sydmcbee/Fish-Egg-Counter-2022/Pictures/base_assembled.jpg

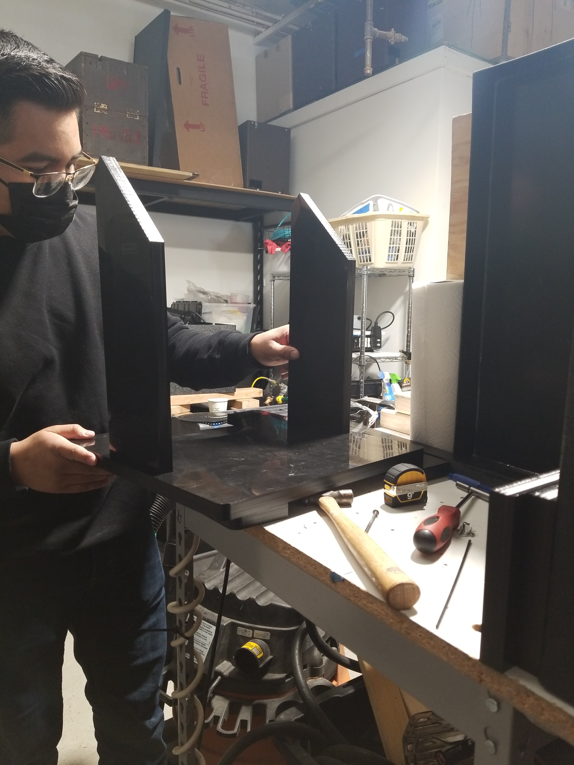
Pictures/base_assembled.jpg
