sydmcbee/Fish-Egg-Counter-2022/Pictures/new_design_Matts.jpg

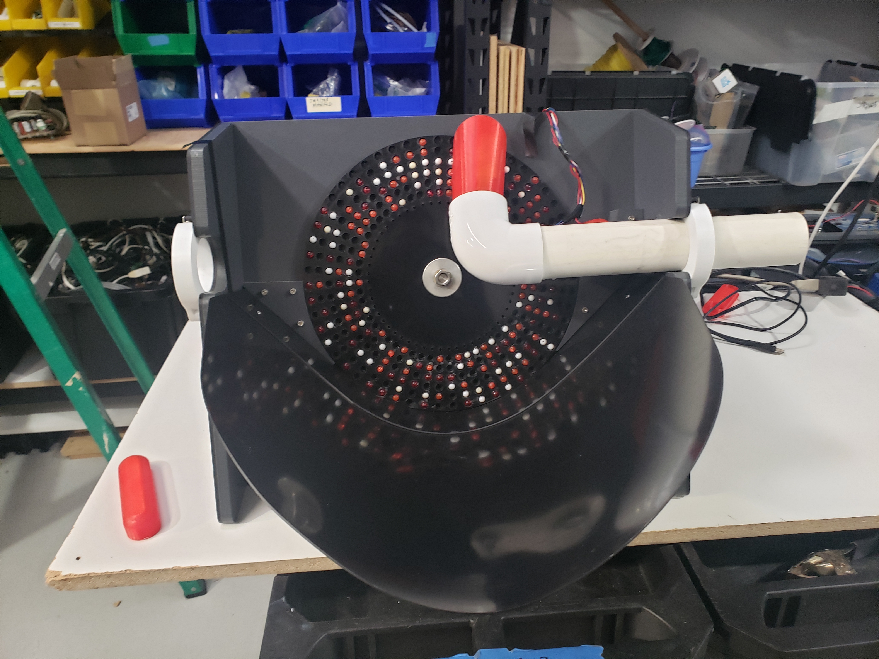
Pictures/new_design_Matts.jpg
