sydmcbee/Fish-Egg-Counter-2022/Weekly Progress Report/1_30_2022 Weekly Progress Report.docx

# Improved Salmon and Trout Egg Counter Weekly Progress Report

Report date: 1/30/2022

- Last Week (time in hours)
  - Team Review
    - Worked on Project Proposal
  - Sydney
    - Project Proposal
  - Sean
    - Project Proposal
  - Agustin
    - Project Proposal
  - Trueman
    - Project Proposal
- Next week
  - Team Plan
    - Write hello world to STM board
    - Take a picture with the ESP32 Cam
    - Complete Final Project Proposal
  - Sydney
    - In-person Meeting on thursday
  - Sean
    - In-person Meeting on thursday
  - Agustin
    - In-person Meeting on Thursday
  - Trueman
    - Power plan
- Blocked
  - Team Blocks
    - Hoping that the Project proposal goes out on time, need both Curt and Johns approval before submission
  - Sydney
  - Sean
    - Possible to Run camera from the larger microprocessor?
  - Agustin
    - Midterm Week
  - Trueman
    - Midterm Week
