sydmcbee/Fish-Egg-Counter-2022/Weekly Progress Report/2_6_2022 Weekly Progress Report.docx

# Improved Salmon and Trout Egg Counter Weekly Progress Report

Report date: 2/6/2022

- Last Week (time in hours)
  - Team Review
    - Project Proposal
    - Capstone progress lecture
  - Sydney
    - Met and worked on code for cam and STM board
  - Sean
    - Met and worked on code for cam and STM board
  - Agustin
    - Met and worked on code for cam and STM board
  - Trueman
    - Tried to find free microSD cards for boards (failed)
- Next week
  - Team Plan
    - Team Review, Pre-review meeting, Meet to work on STM board, Cam, and maybe raspberry pi
  - Sydney
    - Update the Github, source the micro SD card and raspberry pi
  - Sean
    - See how to get openCV into uProc, How to send images through serial GPIO port
  - Agustin
    - Research raspberry pi capabilities, can we get rid of the STM board?
  - Trueman
    - Power Plan
- Blocked
  - Team Blocks
    - Need to email Curt with questions
  - Sydney
    - Can we ditch the STM board?
  - Sean
    - Midterms
  - Agustin
    - One more Midterm
  - Trueman
    - More Midterms
