sydmcbee/Fish-Egg-Counter-2022/Recource Documents/RFFlow - JENSORTER JEIC CAPSTONE SPEC - 2022 - R1.pdf

Target Specifications:
1) Power On Ready to Use
2) Process 300,000 Eggs/Hr - Assume a disk carries 250 Eggs, 20 RPM = 300K Eggs
3) "Batching" Feature
a. User Inputs # Eggs
b. System Batches # Eggs
4) "Counting" Feature
a. Real-Time - # Eggs
b. Post Process - # Eggs/Batch - Good Eggs, Bad Eggs
5) " Image Feature"
a. Dumps images to Screen (Scroll), USB
6) Remote Update of Software (Hook up to PC on Internet)

## JENSORTER "JEIC" CAPSTONE PROJECT - 2022

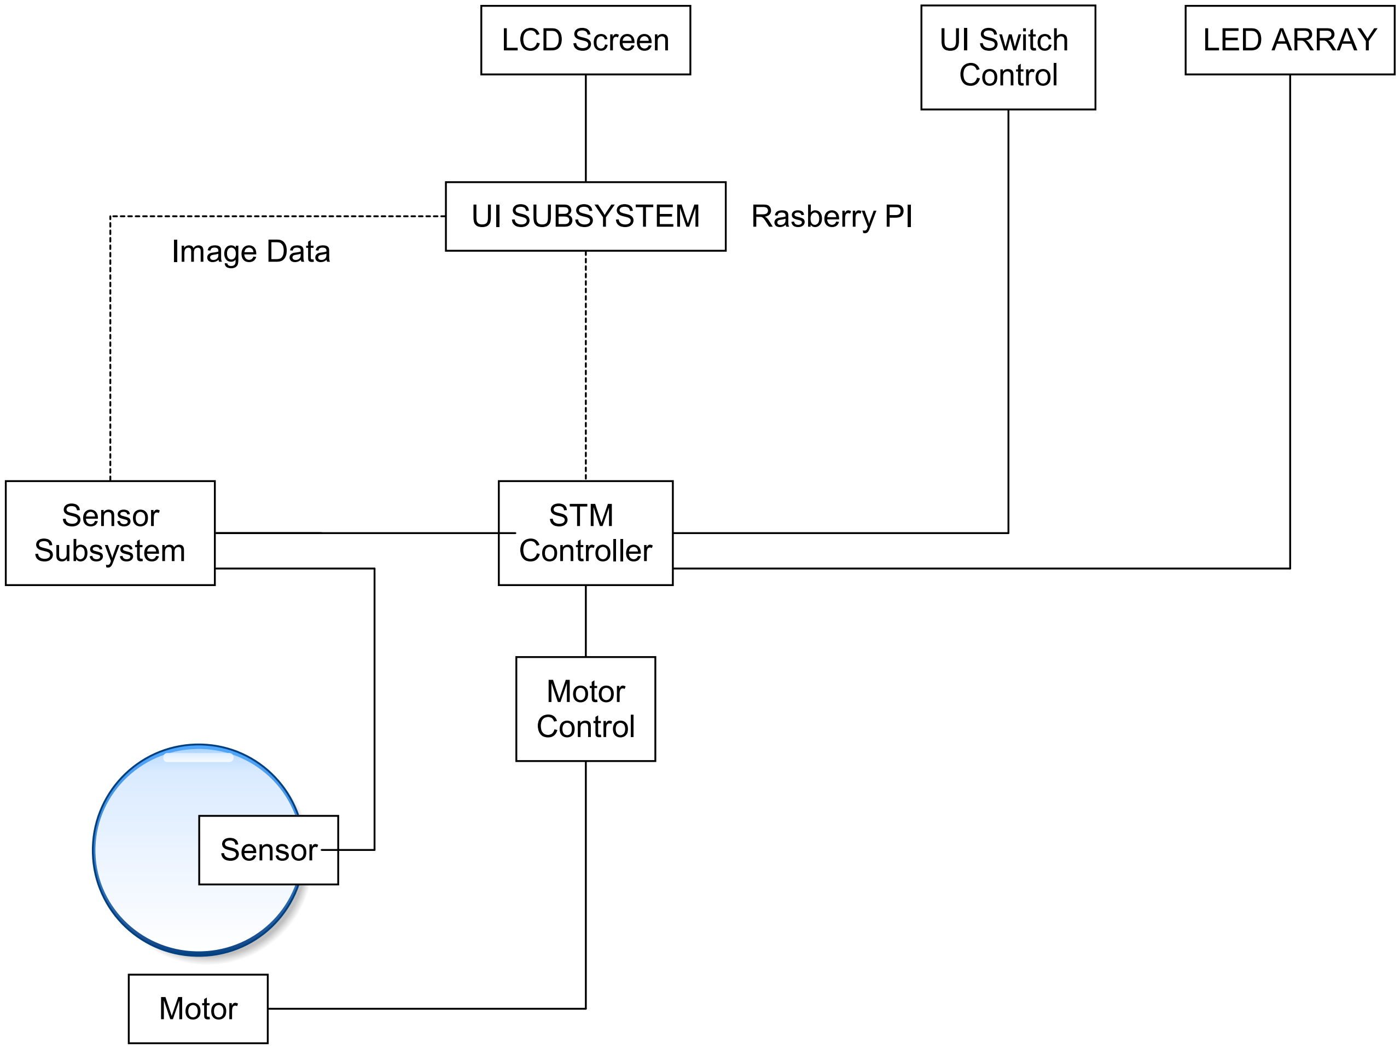
[picture p3: figure]
LCD Screen; UI SUBSYSTEM; Rasberry PI; STM Controller; Sensor Subsystem; Sensor; Motor Control; Motor; UI Switch; LED ARRAY; Control; Image Data
