sydmcbee/Fish-Egg-Counter-2022/Pictures/base_and_plate_assembeled.jpg

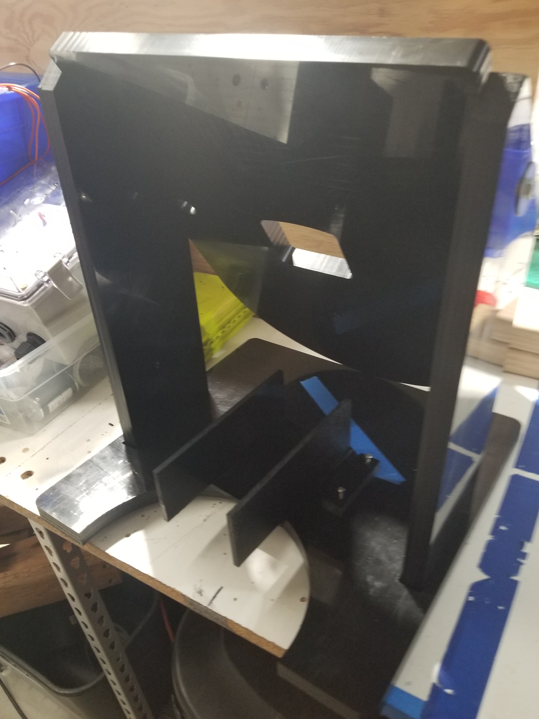
Pictures/base_and_plate_assembeled.jpg
