sydmcbee/Fish-Egg-Counter-2022/Pictures/block diagram.png

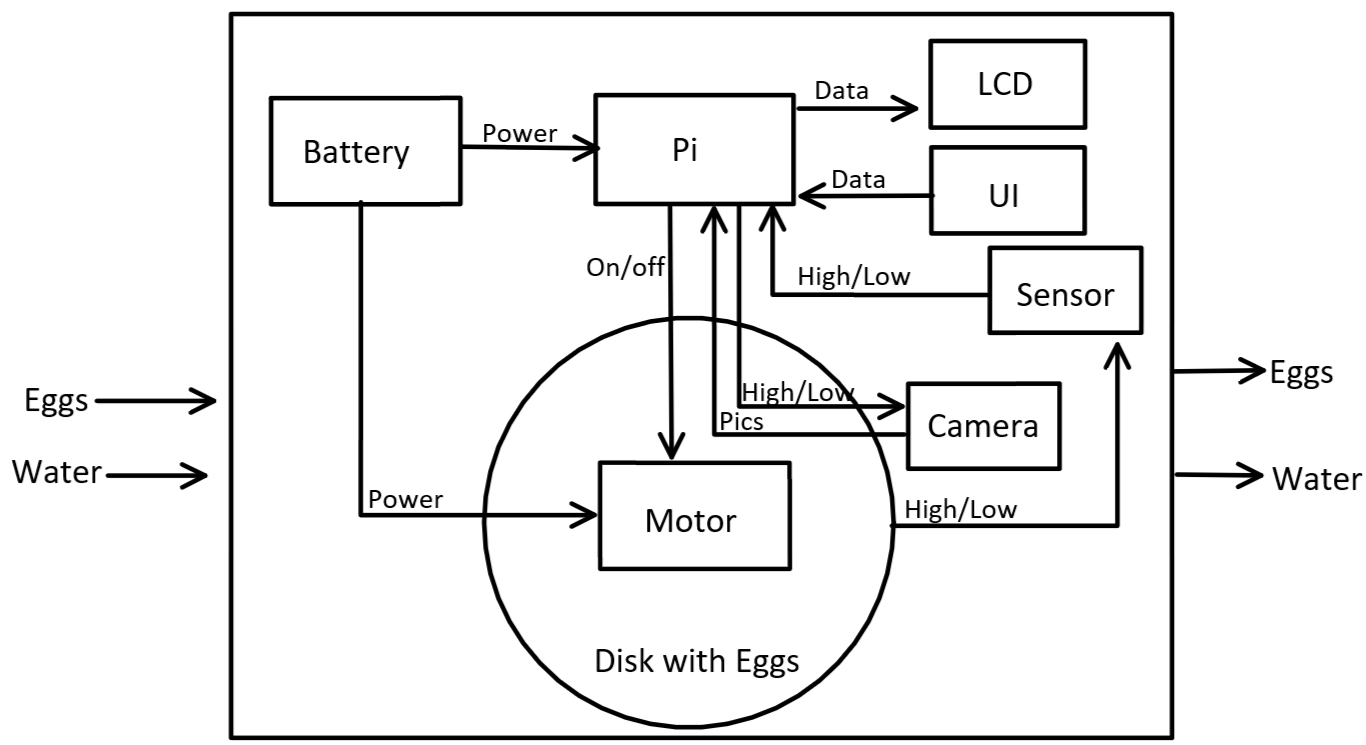
Pictures/block diagram.png
