sydmcbee/Fish-Egg-Counter-2022/Pictures/camera_block.jpg

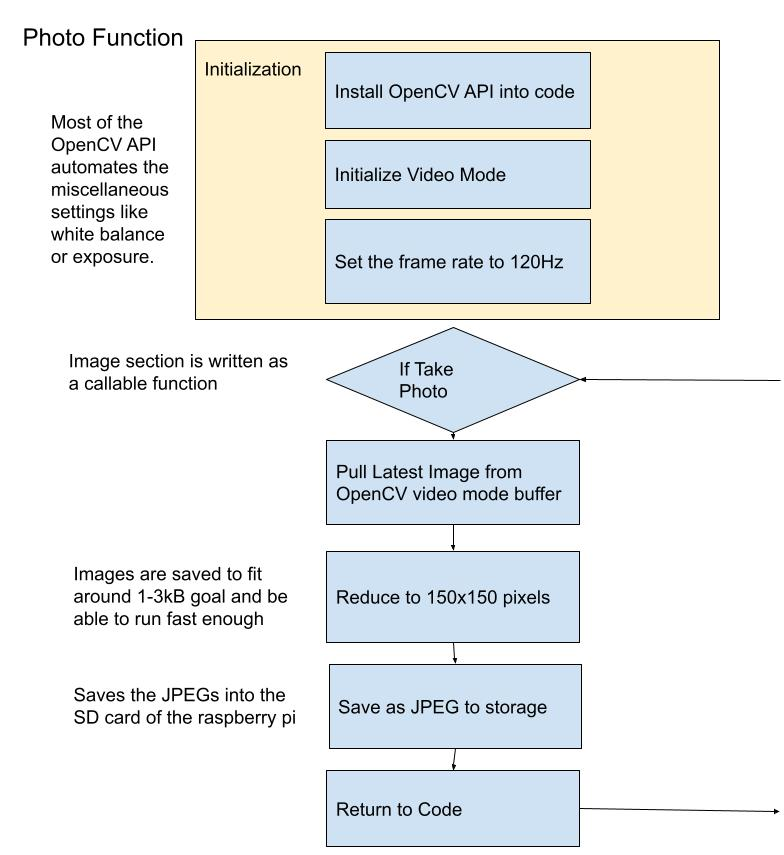
Pictures/camera_block.jpg
