sydmcbee/Fish-Egg-Counter-2022/Pictures/dTQj-8802za0PWdOePcX5d2VXY1fzDKEmULr0gYUjDF9MuVbKbRXO-ENWwPilxfT2EpT9kWhRnJLXRTNyVm9KOn8G_kP1PMThfFYnhR-5R2ii9F7V6LEPkoqE7gjZlxZyjT6fGIWb5VSJZsqkA.png

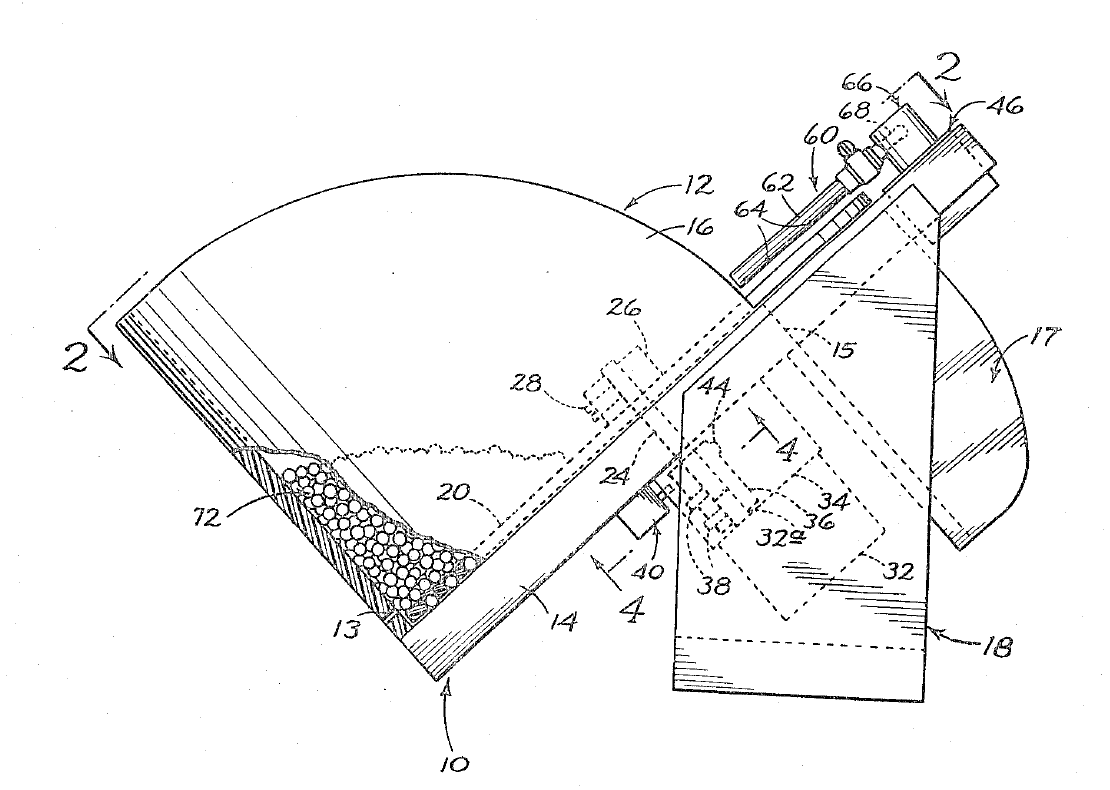
Pictures/dTQj-8802za0PWdOePcX5d2VXY1fzDKEmULr0gYUjDF9MuVbKbRXO-ENWwPilxfT2EpT9kWhRnJLXRTNyVm9KOn8G_kP1PMThfFYnhR-5R2ii9F7V6LEPkoqE7gjZlxZyjT6fGIWb5VSJZsqkA.png
