sydmcbee/Fish-Egg-Counter-2022/Pictures/egg_detection.png

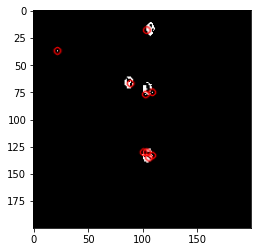
Pictures/egg_detection.png
