sydmcbee/Fish-Egg-Counter-2022/Pictures/gannt2.png

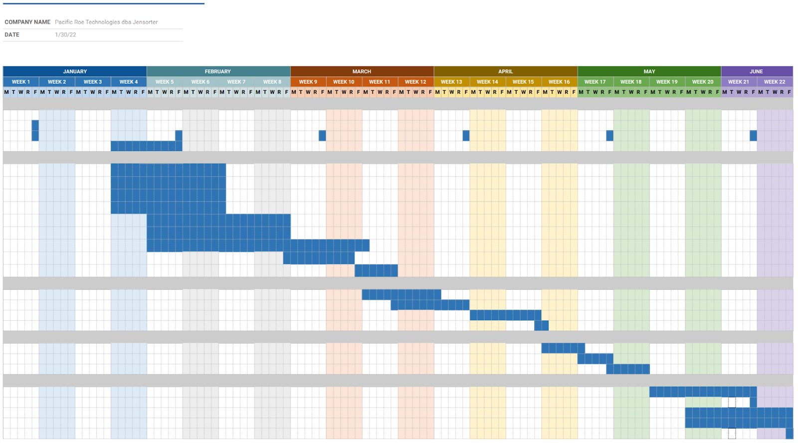
Pictures/gannt2.png
