sydmcbee/Fish-Egg-Counter-2022/Pictures/gannt3.png

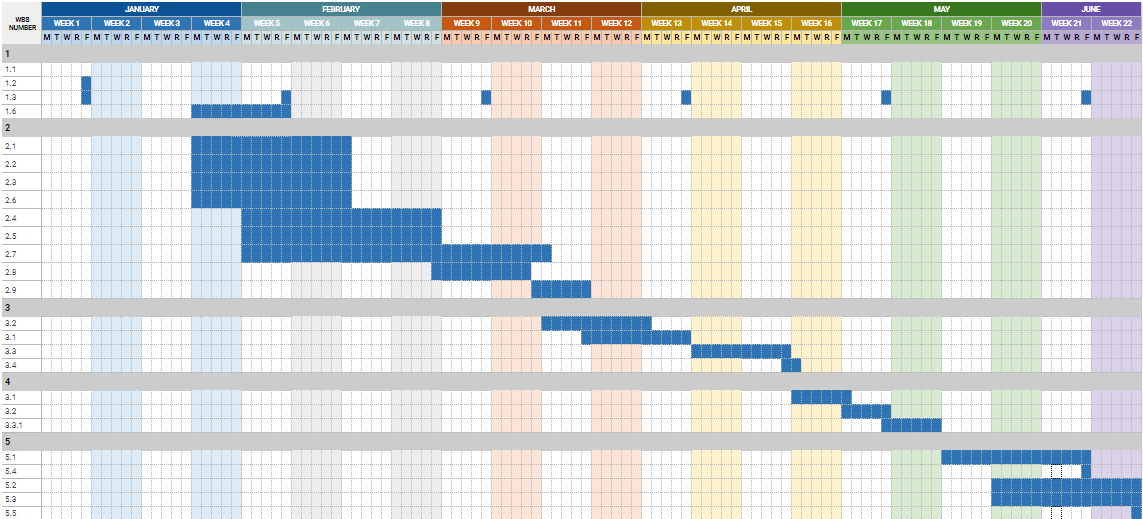
Pictures/gannt3.png
