sydmcbee/Fish-Egg-Counter-2022/Pictures/gZ-_KplSAo2p7i5tI0iG4bt7xw3Kj1Pf9TwzA02HM-rQewxvEXjAwg6dZse_LhUCLho8GwznHhEwNAYjCAxHTOqsGrnDoCFm0W9wVR61-duQgSYPS1Gv7Jip3gpDmW2TXxztqnP1EVmmOwV5iQ.png

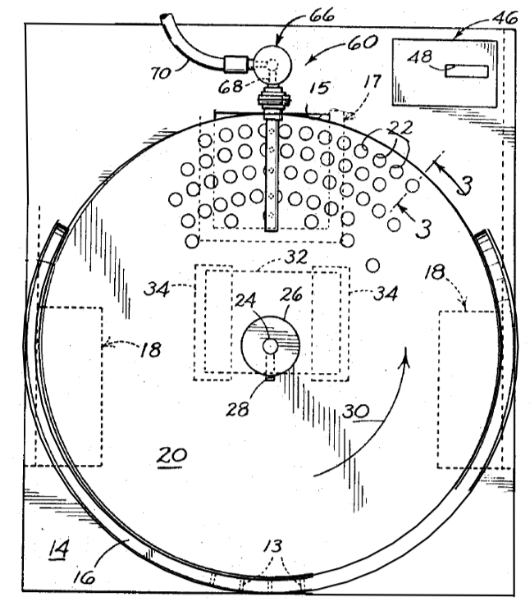
Pictures/gZ-_KplSAo2p7i5tI0iG4bt7xw3Kj1Pf9TwzA02HM-rQewxvEXjAwg6dZse_LhUCLho8GwznHhEwNAYjCAxHTOqsGrnDoCFm0W9wVR61-duQgSYPS1Gv7Jip3gpDmW2TXxztqnP1EVmmOwV5iQ.png
