sydmcbee/Fish-Egg-Counter-2022/Pictures/hose_selected.jpg

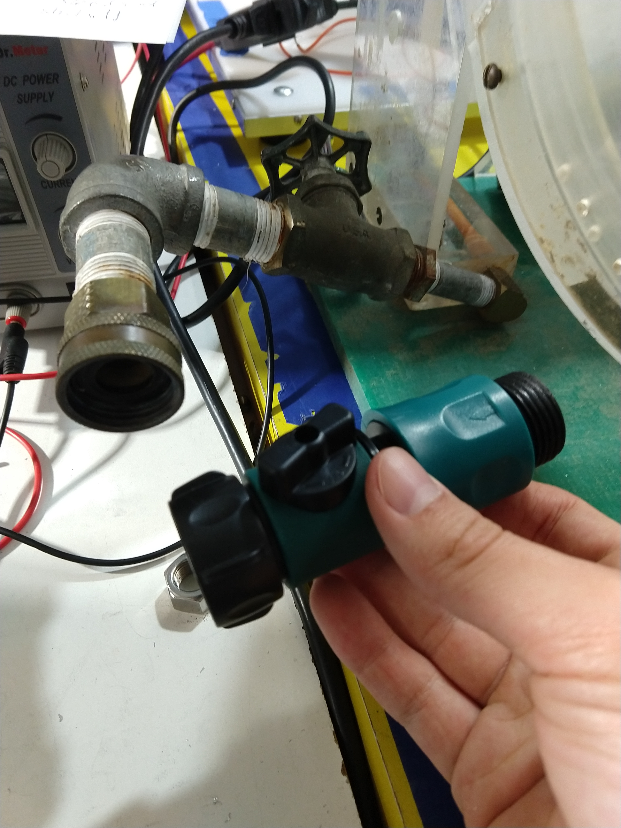
Pictures/hose_selected.jpg
