sydmcbee/Fish-Egg-Counter-2022/Pictures/Use_case_block.png

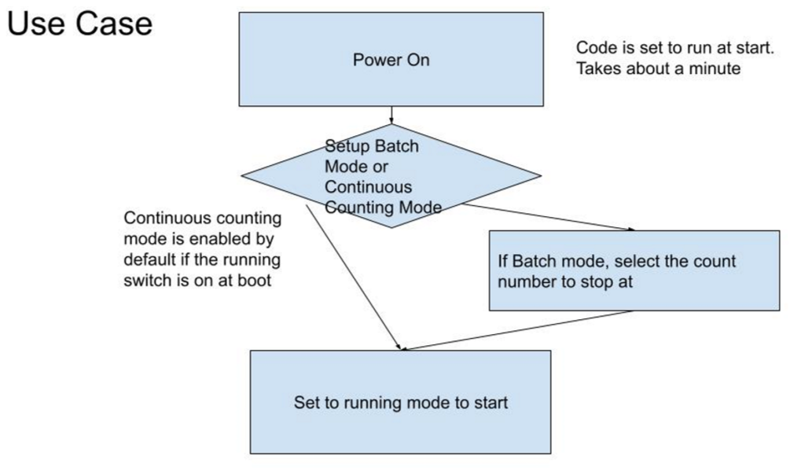
Pictures/Use_case_block.png
