sydmcbee/Fish-Egg-Counter-2022/Pictures/user_block.jpg

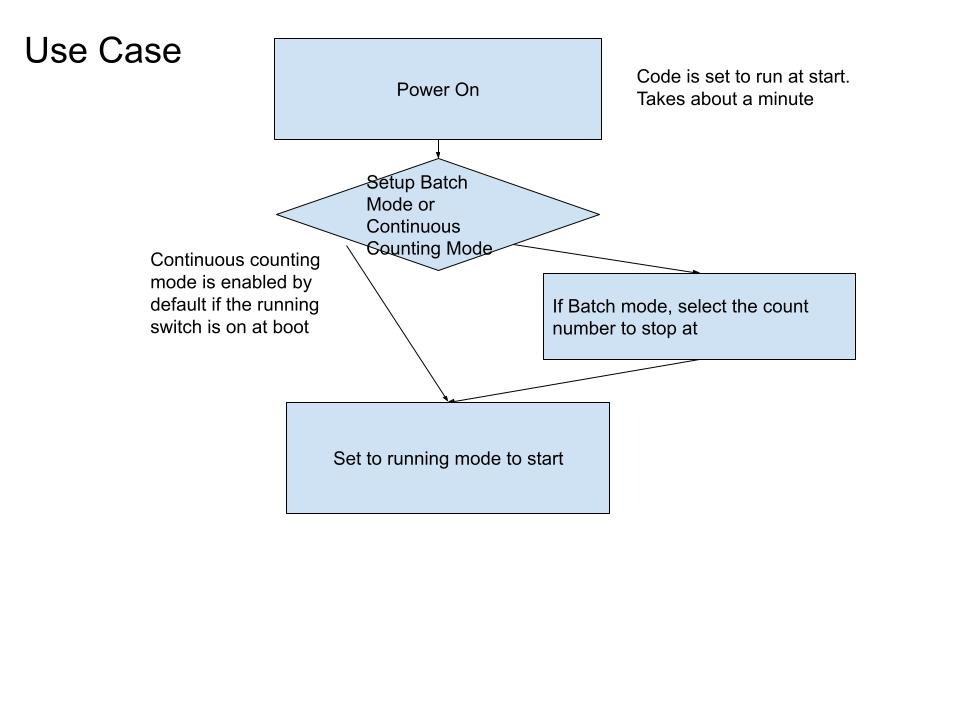
Pictures/user_block.jpg
