sydmcbee/Fish-Egg-Counter-2022/Recource Documents/FA_signature.png

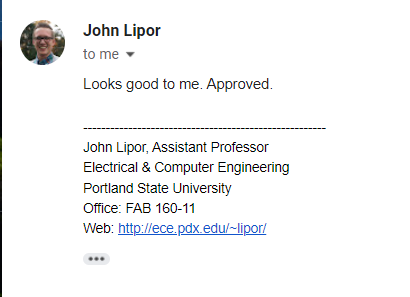
Recource Documents/FA_signature.png
