sydmcbee/Fish-Egg-Counter-2022/Recource Documents/IS_corrections.png

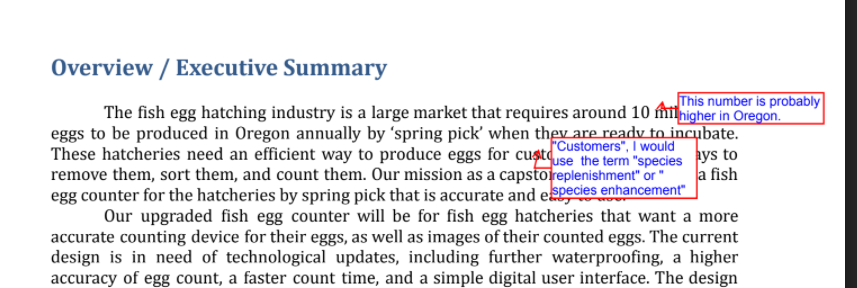
Recource Documents/IS_corrections.png
