sydmcbee/Fish-Egg-Counter-2022/Recource Documents/IS_signature.png

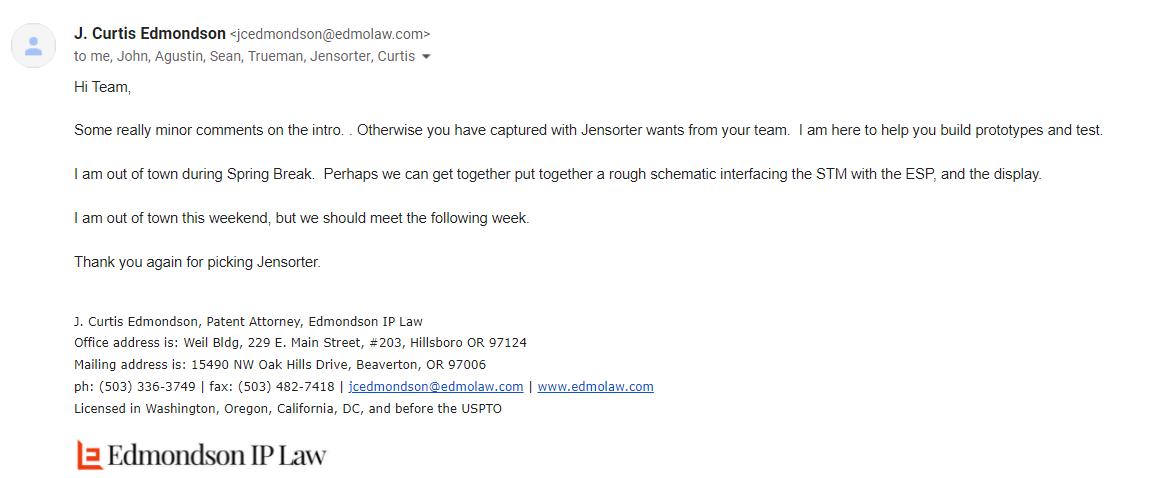
Recource Documents/IS_signature.png
