sydmcbee/Fish-Egg-Counter-2022/Recource Documents/Capstone Bill of Materials.xlsx

Bill Of Materials for: [TEAM 6] [TEAM R.O.E]
Last modified: [2/14/2022]
PCB version: [PCB VERSION #1]
BOM revision: [BOM REVISION #0] |  | P/NP | = Place/Not Place (components marked NP are not stuffed on the board)
Cnt | Part References | P/NP | Mfg | Mfg PN | Description | Dist | Dist Part Number | Order Link | Cost Ea. | Cost Total | Notes
3 | OLED |  | adafruit | 938 | Monochrome 1.3" 128x64 OLED graphic display - STEMMA QT / Qwiic | adafruit | 938 | https://www.adafruit.com/product/938 | $19.98 | $59.94
1 | Motor |  | MOLON | CHM-1250-1M | DC Gearmotor, 50 rpm, 12V, Vented | Zoro | G900461373 | https://www.zoro.com/molon-dc-gearmotor-50-rpm-12v-vented-chm-1250-1m/i/G900461373/?q=CHM-1250-1M | $66.91 | $66.91 | https://www.molon.com/dc-motors-gearmotors/pm-parallel-shaft-gearmotors/chm-dc-detail
1 | Power Source |  | Moticett | P100 | 3.6Ah Ni-Mh, Ryobi 18V Battery | Amazon | B07DNBCSD9 | https://www.amazon.com/Upgraded-3600mAh-Replacement-Battery-Cordless/dp/B07DNBCSD9?hvadid=309813767497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 | $17.99 | $17.99
1 | Processor |  | adafruit |  | Raspberry Pi 4 Model B 2019 Quad Core 64 Bit WiFi Bluetooth |  |  |  |  |  | https://www.adafruit.com/product/4292
 |  |  |  |  |  |  |  |  | TOTAL: | $144.84
VERSION INFO
Rev | Date | Notes
