sydmcbee/Fish-Egg-Counter-2022/CAD files/Hopper for Laser (Full file of project).dxf

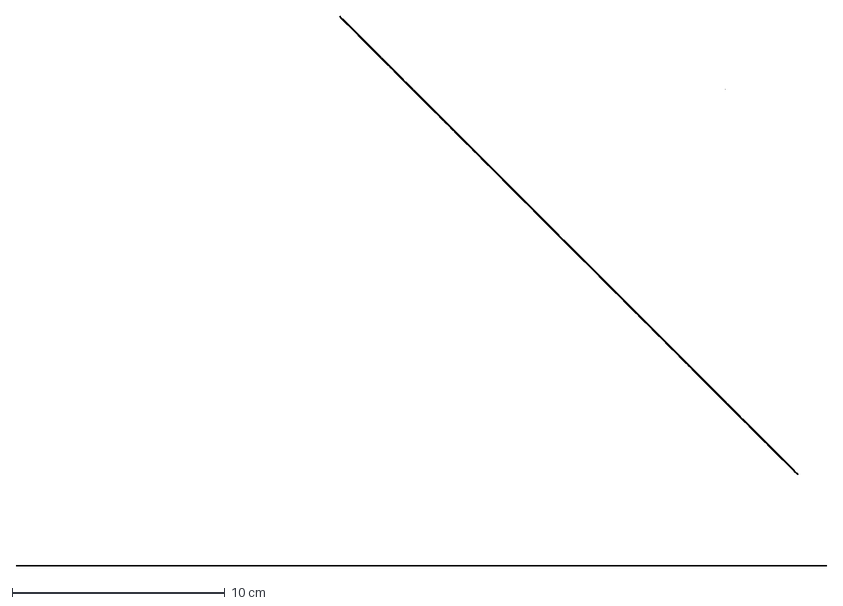
[picture p33: CAD file, 2022-04-11]
CAD files/Hopper for Laser (Full file of project).dxf
38.1 x 25.8 cm
