sydmcbee/Fish-Egg-Counter-2022/CAD files/Full_Project_STL_File.stl

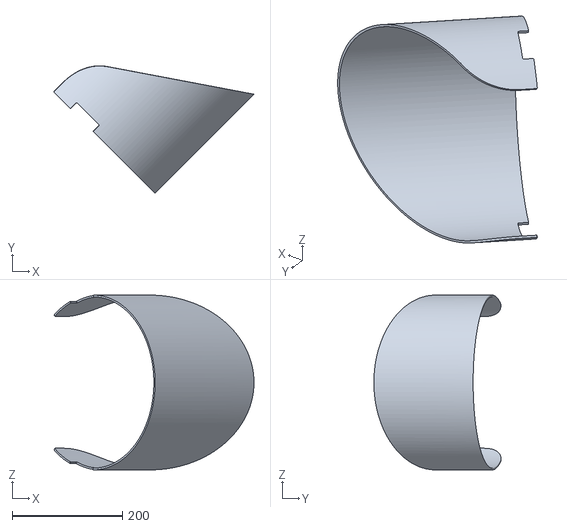
[picture p34: CAD file, 2022-04-11]
CAD files/Full_Project_STL_File.stl
363.2 x 231.2 x 317.5
