sydmcbee/Fish-Egg-Counter-2022/CAD files/IR_sensor_enclosure.step

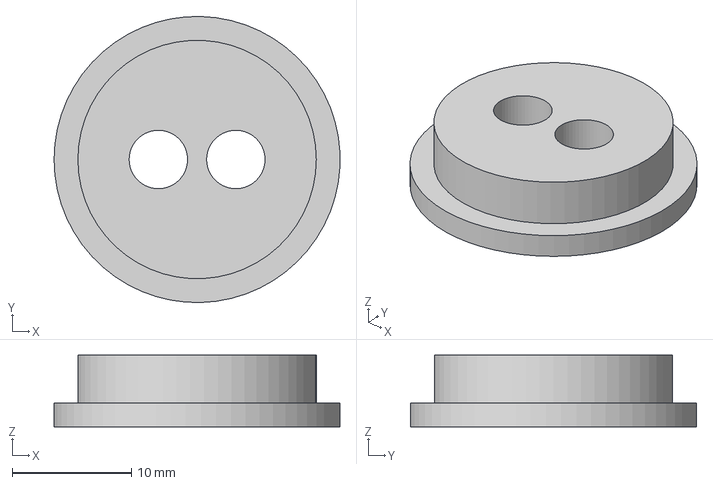
[picture p35: CAD file, 2022-06-04]
CAD files/IR_sensor_enclosure.step
24.0 x 24.0 x 6.00 mm
