sydmcbee/Fish-Egg-Counter-2022/Recource Documents/sensor_bar_design/7a - SUBASSEMBLY - SENSORS/sensor bar B.3mf

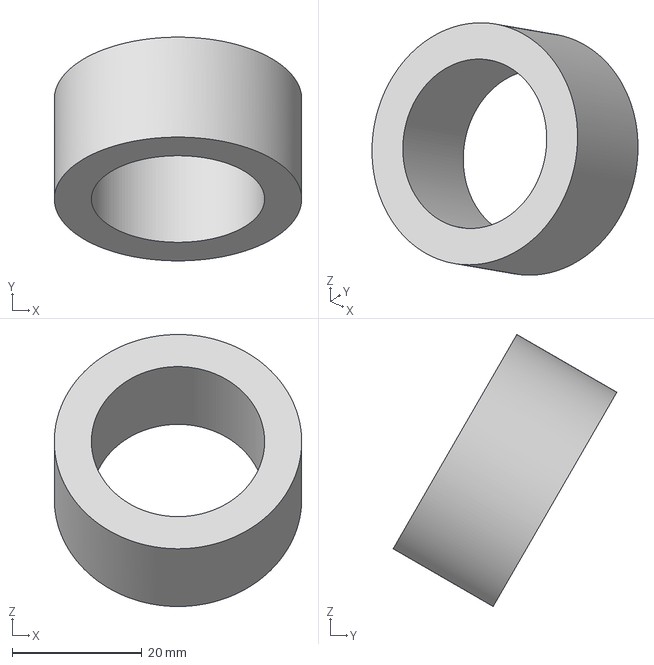
[picture p36: CAD file, 2022-04-11]
Recource Documents/sensor_bar_design/7a - SUBASSEMBLY - SENSORS/sensor bar B.3mf
38.1 x 34.4 x 41.9 mm
