sydmcbee/Fish-Egg-Counter-2022/Recource Documents/sensor_bar_design/7a - SUBASSEMBLY - SENSORS/sensor block top V2, 0.125, clear acrylic.dxf

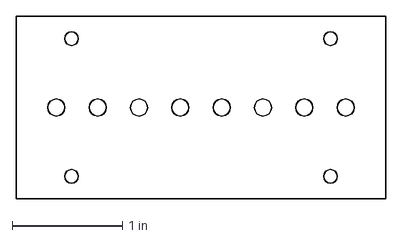
[picture p37: CAD file, 2022-04-11]
Recource Documents/sensor_bar_design/7a - SUBASSEMBLY - SENSORS/sensor block top V2, 0.125, clear acrylic.dxf
3.35 x 1.66 in
