sydmcbee/Fish-Egg-Counter-2022/CAD files/DXF_FIle_For_Laser_DISK.dxf

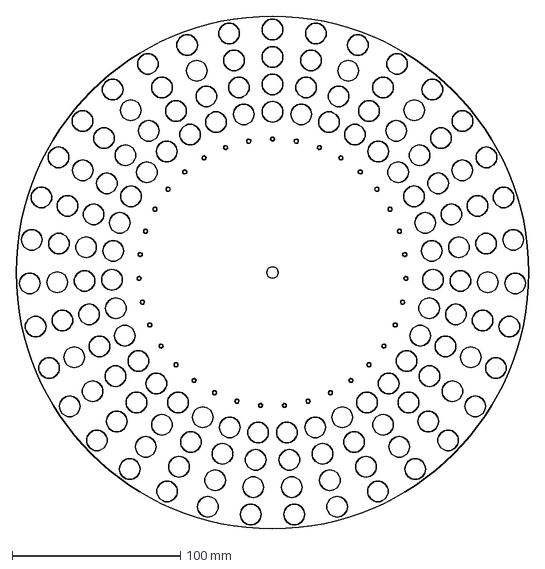
[picture p38: CAD file, 2022-04-11]
CAD files/DXF_FIle_For_Laser_DISK.dxf
304.8 x 304.8 mm
