sydmcbee/Fish-Egg-Counter-2022/Recource Documents/sensor_bar_design/7a - SUBASSEMBLY - SENSORS/JSBC sensor bar lid v2.stl

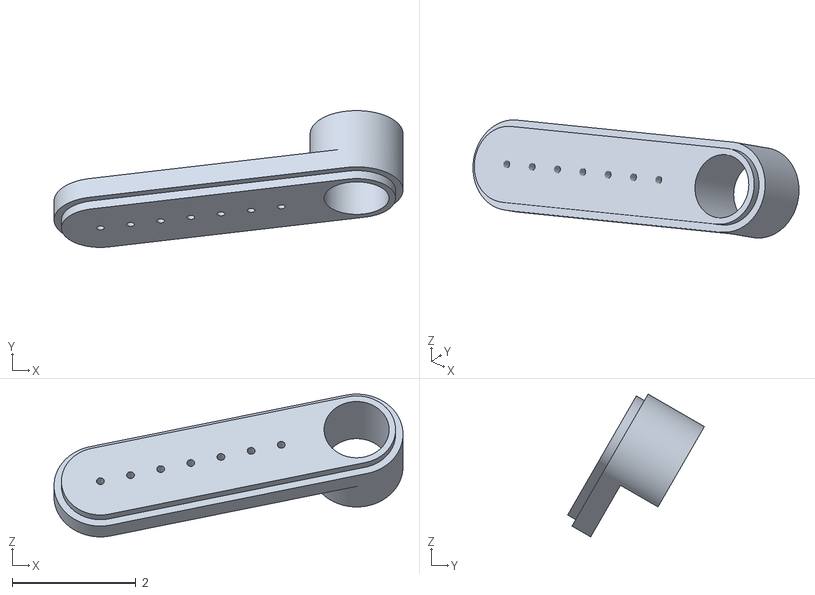
[picture p39: CAD file, 2022-04-11]
Recource Documents/sensor_bar_design/7a - SUBASSEMBLY - SENSORS/JSBC sensor bar lid v2.stl
5.64 x 2.21 x 2.31
