sydmcbee/Fish-Egg-Counter-2022/Recource Documents/sensor_bar_design/7a - SUBASSEMBLY - SENSORS/sensor bar A.3mf

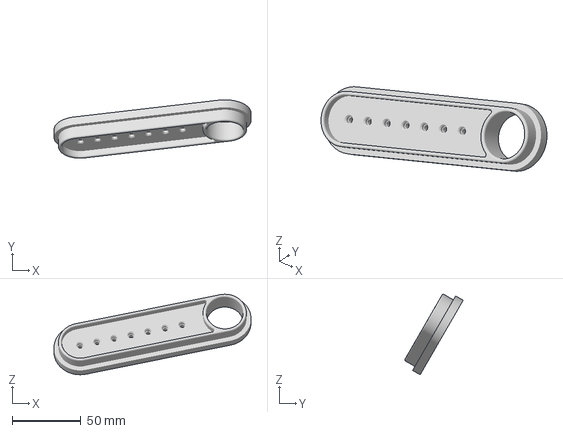
[picture p40: CAD file, 2022-04-11]
Recource Documents/sensor_bar_design/7a - SUBASSEMBLY - SENSORS/sensor bar A.3mf
143.2 x 42.4 x 58.6 mm
