sydmcbee/Fish-Egg-Counter-2022/CAD files/base.step

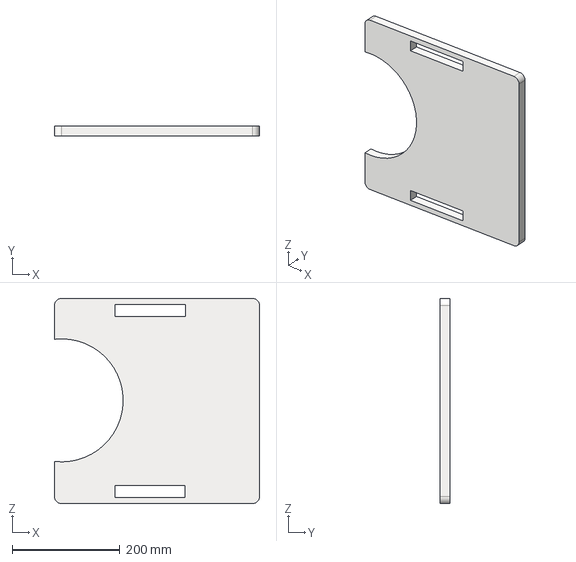
[picture p41: CAD file, 2022-03-07]
CAD files/base.step
381.0 x 19.0 x 381.0 mm
