sydmcbee/Fish-Egg-Counter-2022/Recource Documents/sensor_bar_design/7a - SUBASSEMBLY - SENSORS/JSBC sensor bar v2.stl

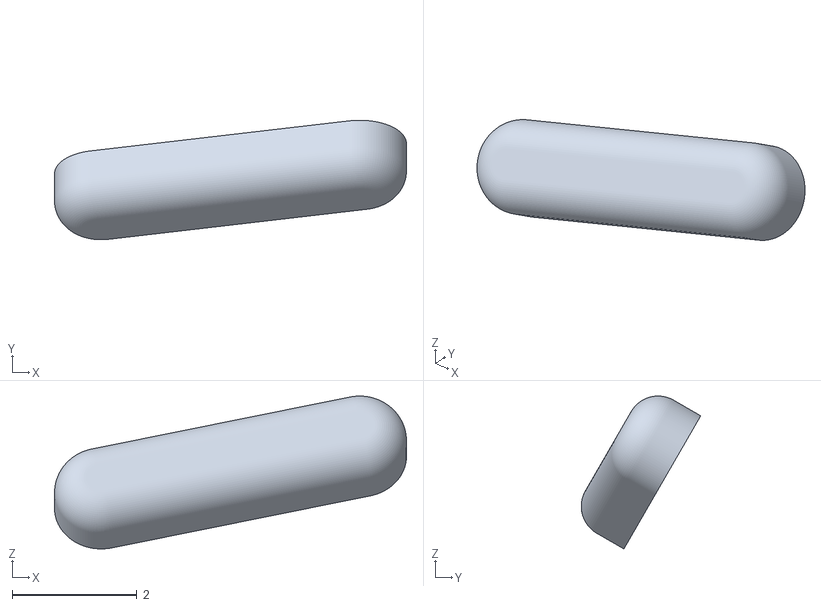
[picture p42: CAD file, 2022-04-11]
Recource Documents/sensor_bar_design/7a - SUBASSEMBLY - SENSORS/JSBC sensor bar v2.stl
5.64 x 1.91 x 2.45
