sydmcbee/Fish-Egg-Counter-2022/CAD files/11.9 - 6 DISK.stl

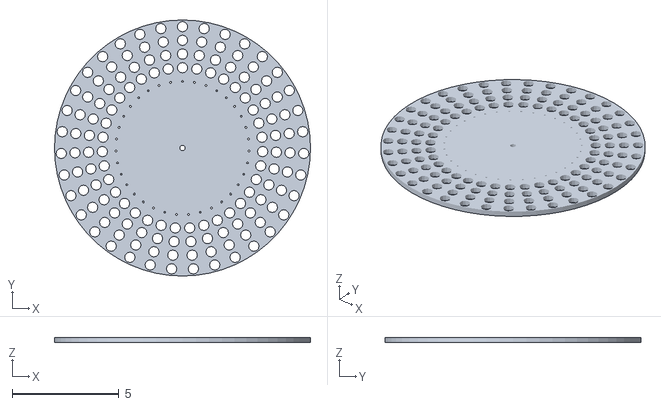
[picture p43: CAD file, 2022-03-07]
CAD files/11.9 - 6 DISK.stl
12.0 x 12.0 x 0.25
