sydmcbee/Fish-Egg-Counter-2022/CAD files/John_1 v5.step

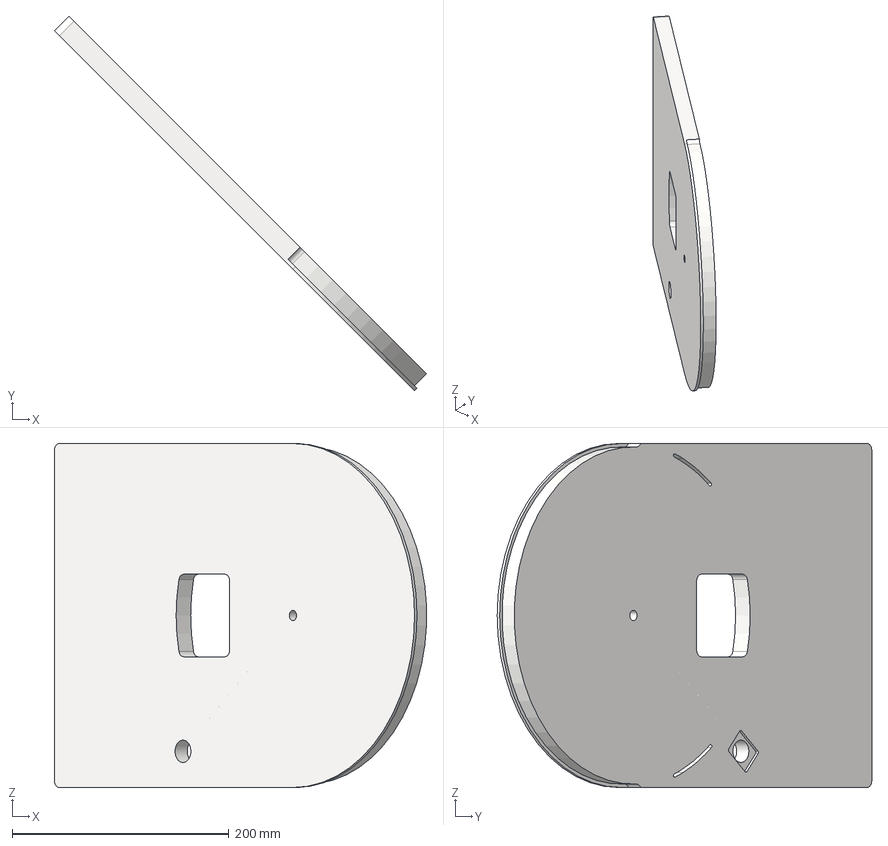
[picture p46: CAD file, 2022-03-07]
CAD files/John_1 v5.step
343.3 x 345.7 x 317.5 mm
