sydmcbee/Fish-Egg-Counter-2022/CAD files/left_side.step

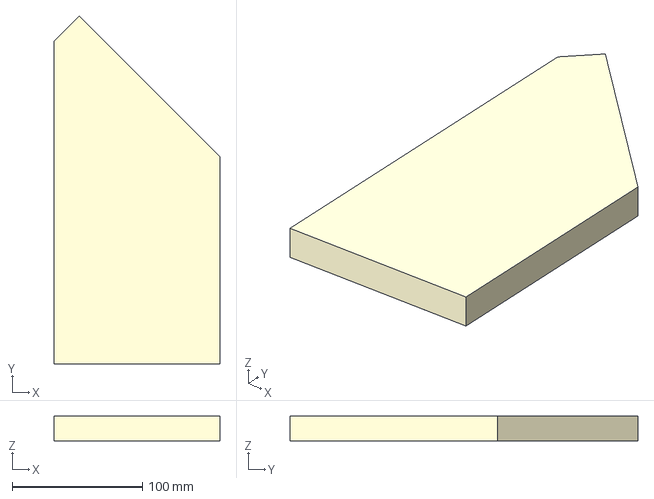
[picture p48: CAD file, 2022-03-07]
CAD files/left_side.step
127.0 x 266.7 x 19.1 mm
