sydmcbee/Fish-Egg-Counter-2022/Recource Documents/sensor_bar_design/7a - SUBASSEMBLY - SENSORS/JSBC sensor bar.stl

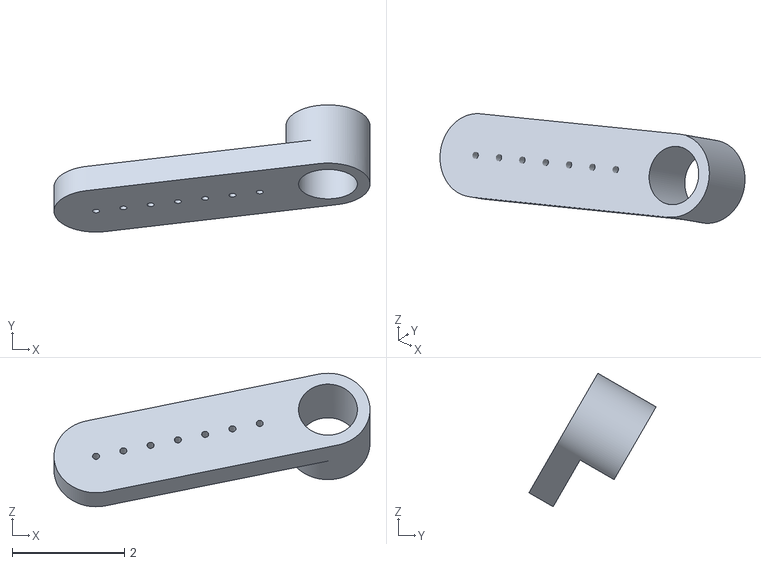
[picture p50: CAD file, 2022-04-11]
Recource Documents/sensor_bar_design/7a - SUBASSEMBLY - SENSORS/JSBC sensor bar.stl
5.64 x 2.27 x 2.38
