sydmcbee/Fish-Egg-Counter-2022/(list of files, cad)

Other CAD files:
CAD files/hopper.step
CAD files/right_side.step
CAD files/Full_Project_Egg_Counter.f3d
