sydmcbee/Fish-Egg-Counter-2022/Pictures/3D_print_forsensors.jpg

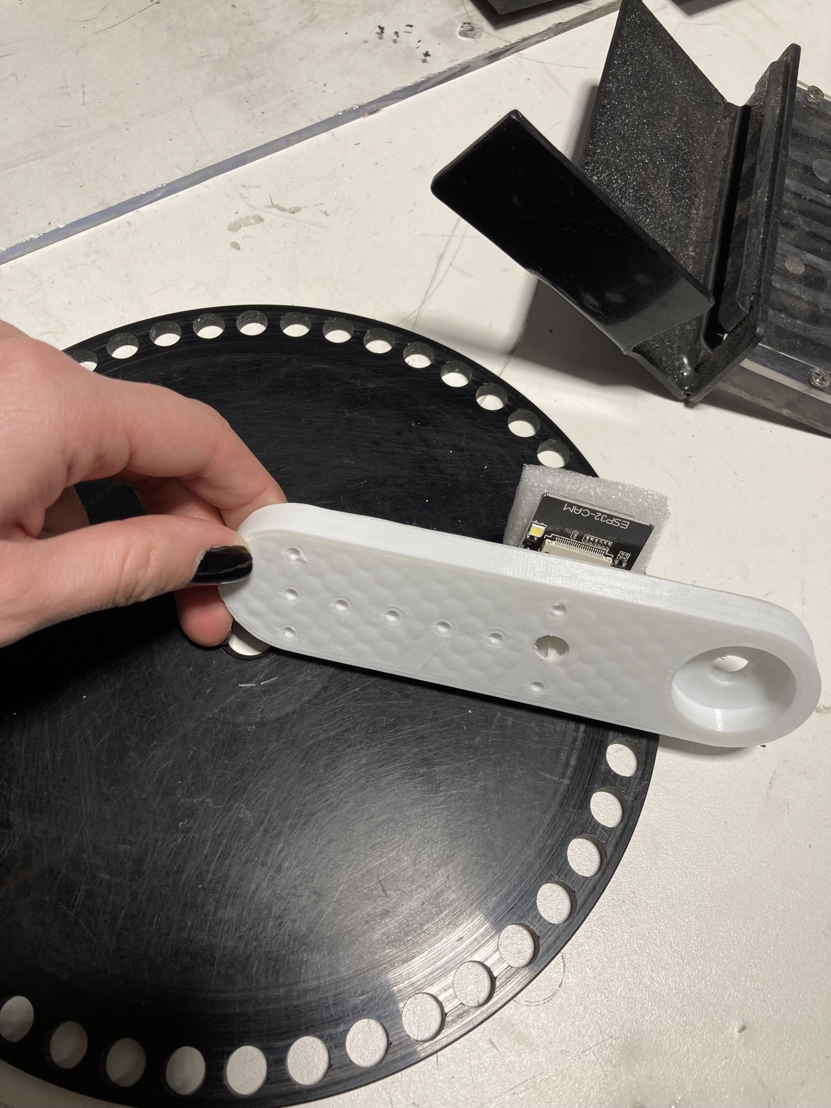
Pictures/3D_print_forsensors.jpg
