sydmcbee/Fish-Egg-Counter-2022/Pictures/hose_system_assembled.jpg

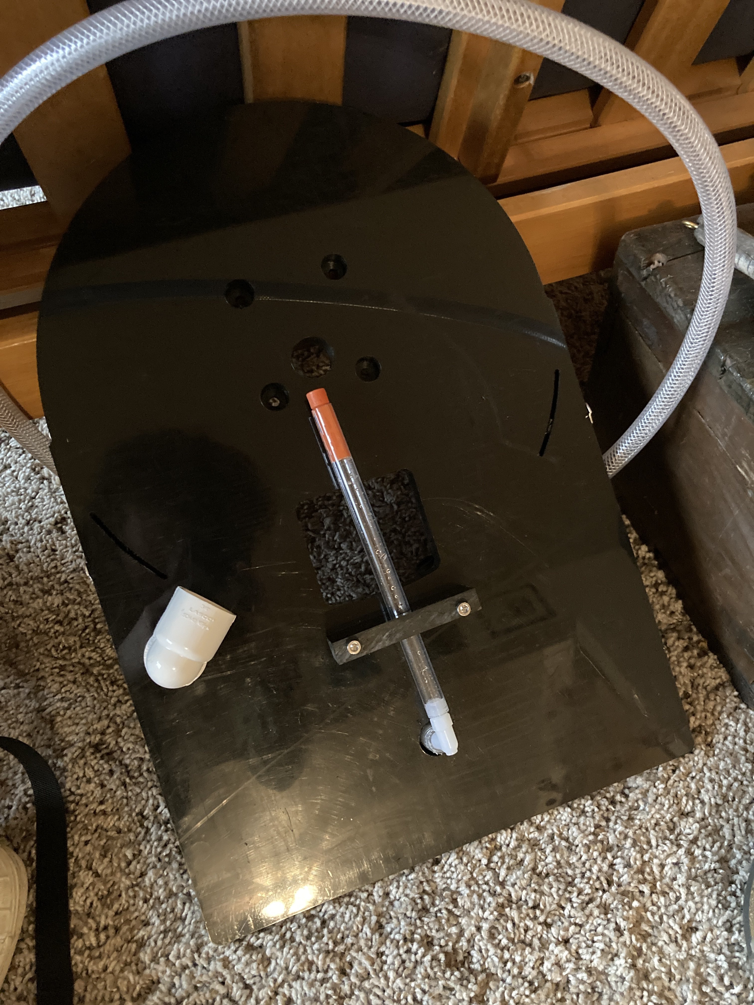
Pictures/hose_system_assembled.jpg
