sydmcbee/Fish-Egg-Counter-2022/(commit log)

2022-01-17 Added a filter for an example
2022-02-11 Added some WPR and documents from google drive
    [Gantt chart.xlsx]
2022-03-07 Added cad and a WPR
    [11.9 - 6 DISK.stl, John_1 v5.step, base.step, hopper.step, left_side.step, right_side.step]
2022-03-08 Add files via upload
    Unfinished BOM. Still needs a variety of components added to it such as several circuit components, and all hopper materials.
    [Capstone Bill of Materials.xlsx]
2022-03-08 Power budget tables
    Early power budget from February. Divided into two sections due to not knowing at the time what components would take direct power from the battery or from the Raspberry Pi. Battery specifications may change in later additions and so could the Raspberry Pi model. Components missing descriptions had not been decided at the point of creation.
2022-03-08 User Manual
    Template for User Manual with changes made to the title, headers, and footers. Expect heavy changes going forward and possibly a reformatting at a later stage. Sections written in blue are advisory statements meant to be removed once completed.
2022-03-22 Create CameraCapture&Detect
2022-04-11 Dumping CAD files and cleaning some stuff up
    [JSBC Body2.stl, JSBC sensor bar lid v2.stl, JSBC sensor bar v2.stl, JSBC sensor bar.stl, sensor bar A.3mf, sensor bar B.3mf, sensor bar C.3mf, sensor block dimentions.dxf]
2022-04-11 Cad files and WPR
    [DXF_FIle_For_Laser_DISK.dxf, Full_Project_Egg_Counter.f3d, Full_Project_STL_File.stl, Hopper for Laser (Full file of project).dxf]
2022-04-12 More filled out this time
    The entire document will need strict review and most likely heavy edits once the first prototype is fully assembled.
2022-04-12 Preliminarily filled out version
    This document will need heavy review and edits once the first prototype is built.
    Current debatable portions are highlighted.
    Later sections are left undone due to confusion on legal responsibilities.
2022-06-04 added some cad and code and WPR
    [IR_sensor_enclosure.step]
2022-06-09 Updated to final Prototype
2022-06-09 Final Version (Hopefully)
    Updated it to fit the final Prototype. Erased unused sections and left over notes. Uploaded to the correct section.
